jonathanyujra/revision_stick-lpc1769/README.md

# revision_stick-lpc1769
Módulo Stick LPC1769
