jonathanyujra/revision_stick-lpc1769/Gabinete/TP3-gabinete.FCStd

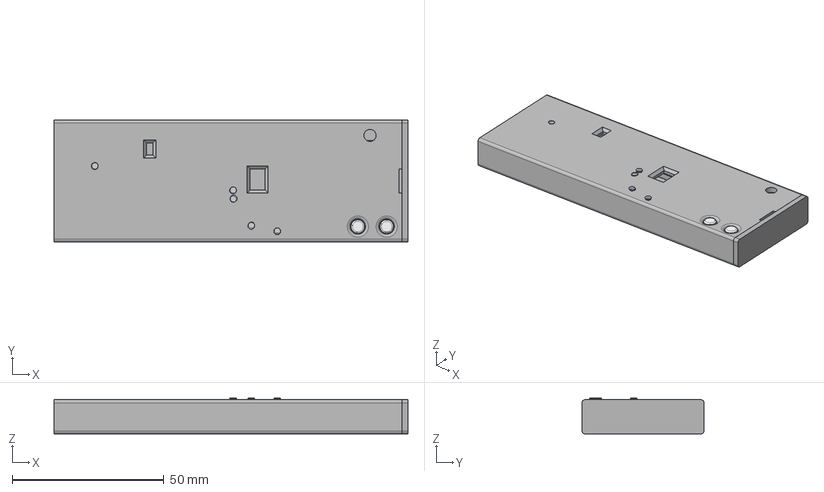
[picture p10: CAD file, 2025-09-14]
Gabinete/TP3-gabinete.FCStd
116.5 x 40.2 x 11.8 mm
Gabinete-tapa
Gabinete-sw1
Gabinete-sw2
Gabinete-cuerpo
Gabinete-TuboDeLuz
Gabinete-TuboDeLuz1
Gabinete-TuboDeLuz2
Gabinete-TuboDeLuz3
Gabinete-TuboDeLuz4
