jonathanyujra/revision_stick-lpc1769/Módulo Stick LPC 1769/modelos3d/SOIC-8-1.step

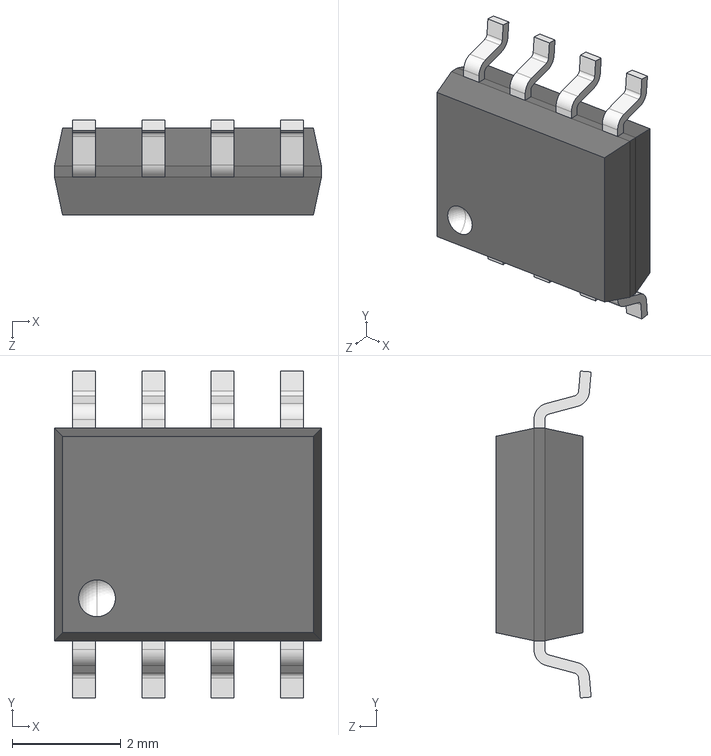
[picture p11: CAD file, 2025-09-14]
Módulo Stick LPC 1769/modelos3d/SOIC-8-1.step
4.90 x 6.00 x 1.75 mm
