jonathanyujra/revision_stick-lpc1769/Módulo Stick LPC 1769/modelos3d/VFQFN-32-5x5 - EQ.STEP

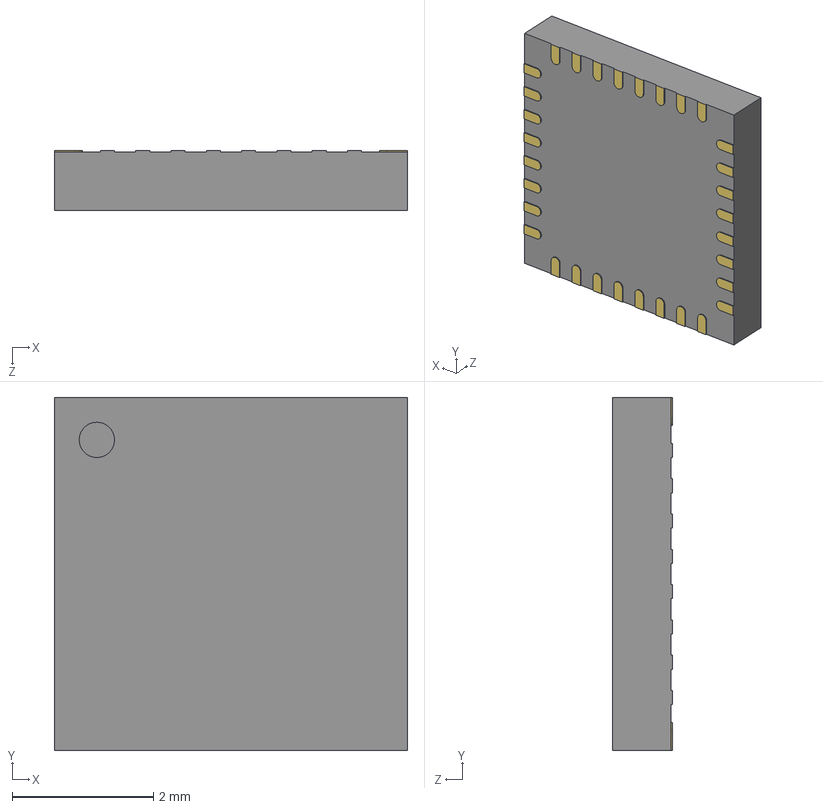
[picture p12: CAD file, 2025-09-14]
Módulo Stick LPC 1769/modelos3d/VFQFN-32-5x5 - EQ.STEP
5.00 x 5.00 x 0.85 mm
