jonathanyujra/revision_stick-lpc1769/Módulo Stick LPC 1769/modelos3d/USB2.0_MICRO_B.stp

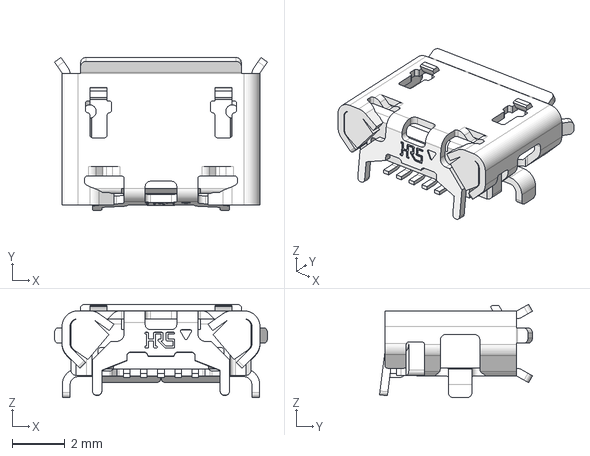
[picture p13: CAD file, 2025-09-14]
Módulo Stick LPC 1769/modelos3d/USB2.0_MICRO_B.stp
8.09 x 5.81 x 3.55 mm
