jonathanyujra/revision_stick-lpc1769/Módulo Stick LPC 1769/modelos3d/QFN65-8X8_M.STEP

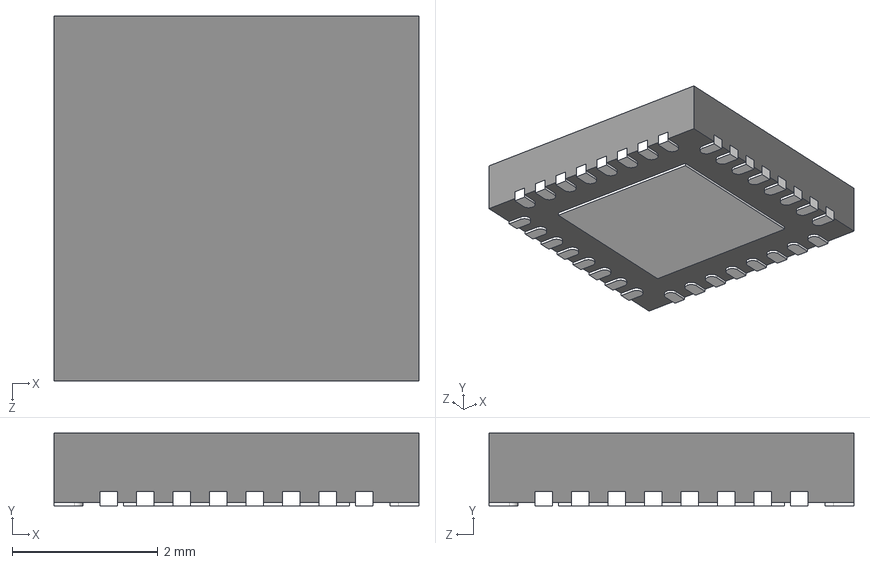
[picture p14: CAD file, 2025-09-14]
Módulo Stick LPC 1769/modelos3d/QFN65-8X8_M.STEP
5.00 x 1 x 5.00 mm
