jonathanyujra/revision_stick-lpc1769/Módulo Stick LPC 1769/modelos3d/RGB_PLCC(c).STEP

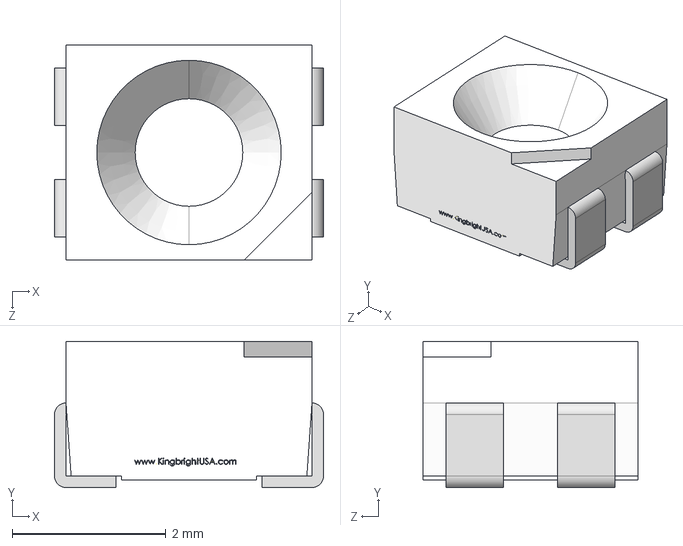
[picture p15: CAD file, 2025-09-14]
Módulo Stick LPC 1769/modelos3d/RGB_PLCC(c).STEP
3.50 x 1.90 x 2.80 mm
