jonathanyujra/revision_stick-lpc1769/Módulo Stick LPC 1769/modelos3d/M50-3600542.IGS

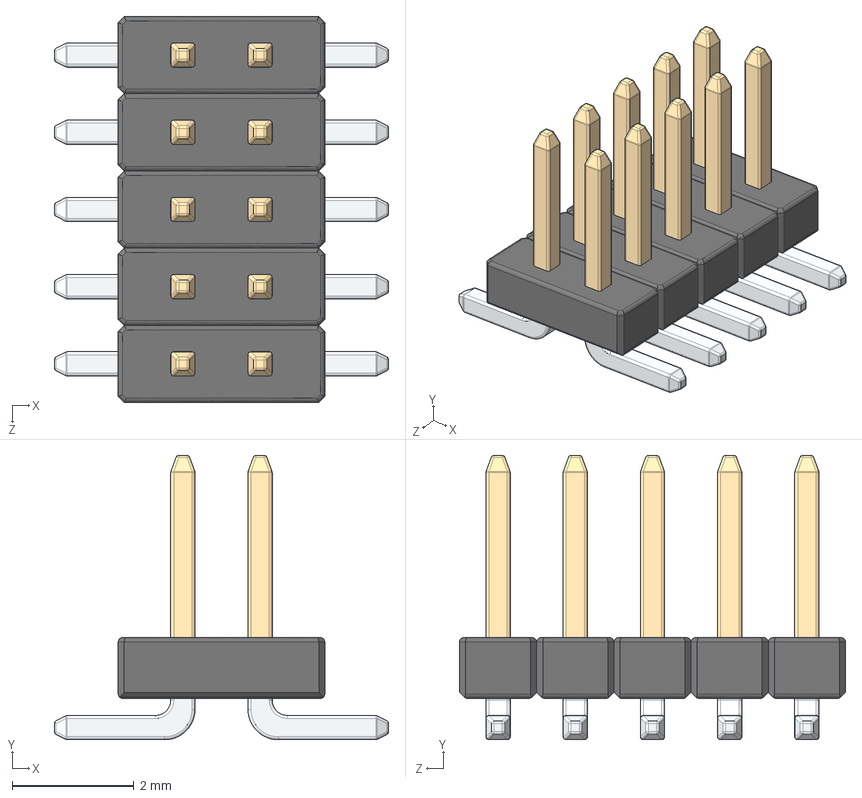
[picture p16: CAD file, 2025-09-14]
Módulo Stick LPC 1769/modelos3d/M50-3600542.IGS
5.50 x 4.68 x 6.35 mm
