jonathanyujra/revision_stick-lpc1769/Módulo Stick LPC 1769/output/Módulo Stick LPC1769-esquemático.pdf

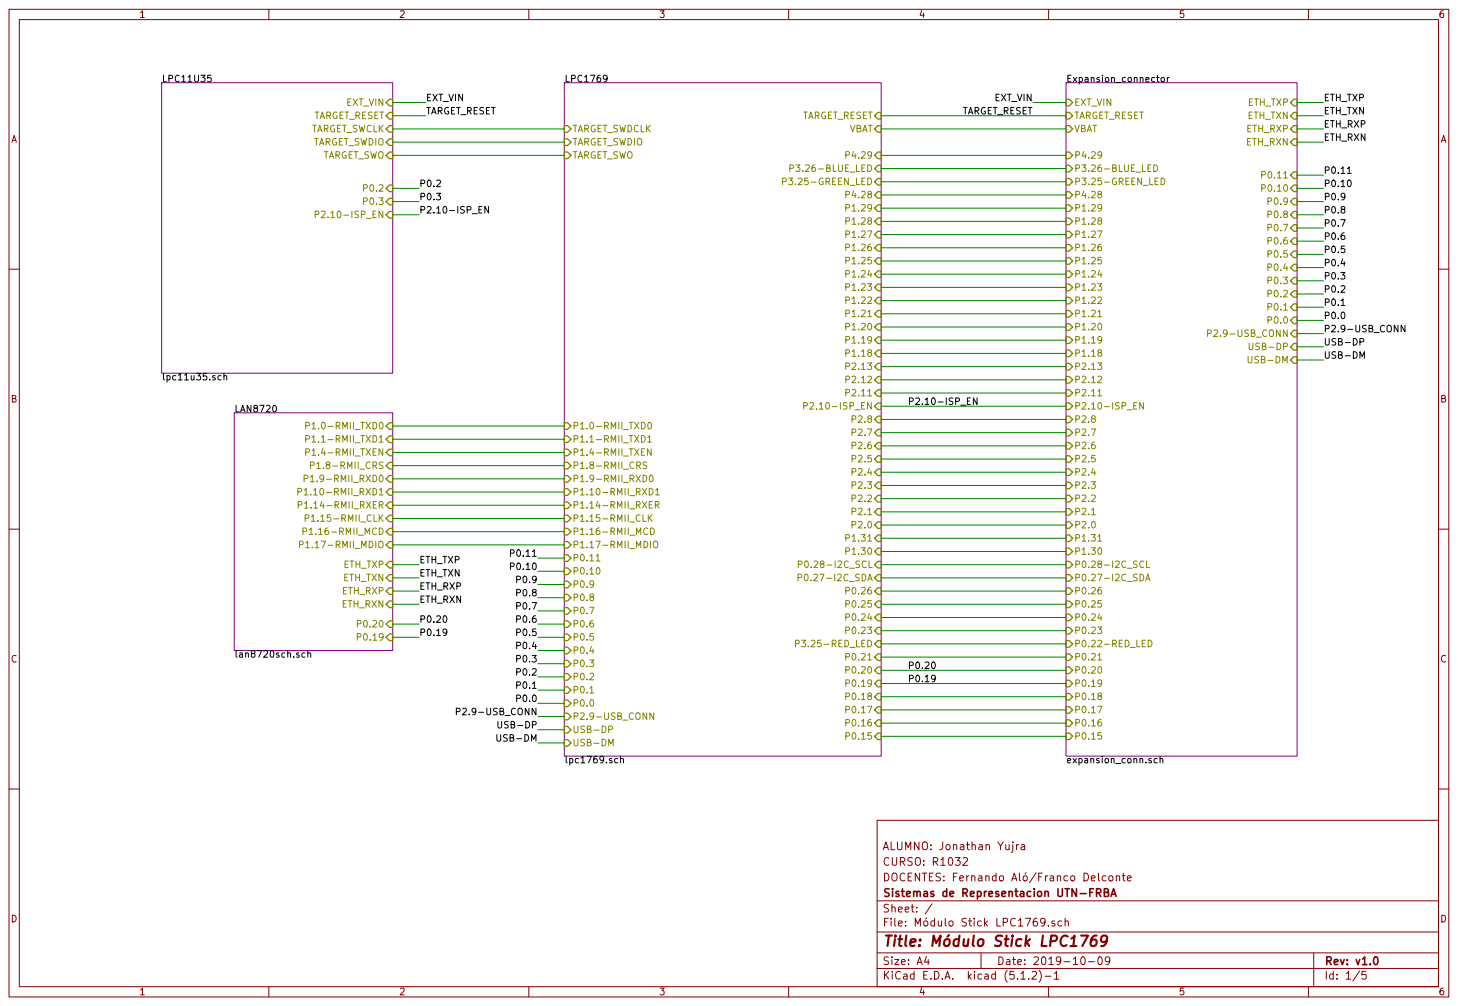
[picture p17: page 1]

USB-DP USB-DM

DOCENTES: Fernando Aló/Franco Delconte CURSO: R1032 ALUMNO: Jonathan Yujra

File: Módulo Stick LPC1769.sch Sheet: / Sistemas de Representacion UTN-FRBA

Id: 1/5 Title: Módulo Stick LPC1769

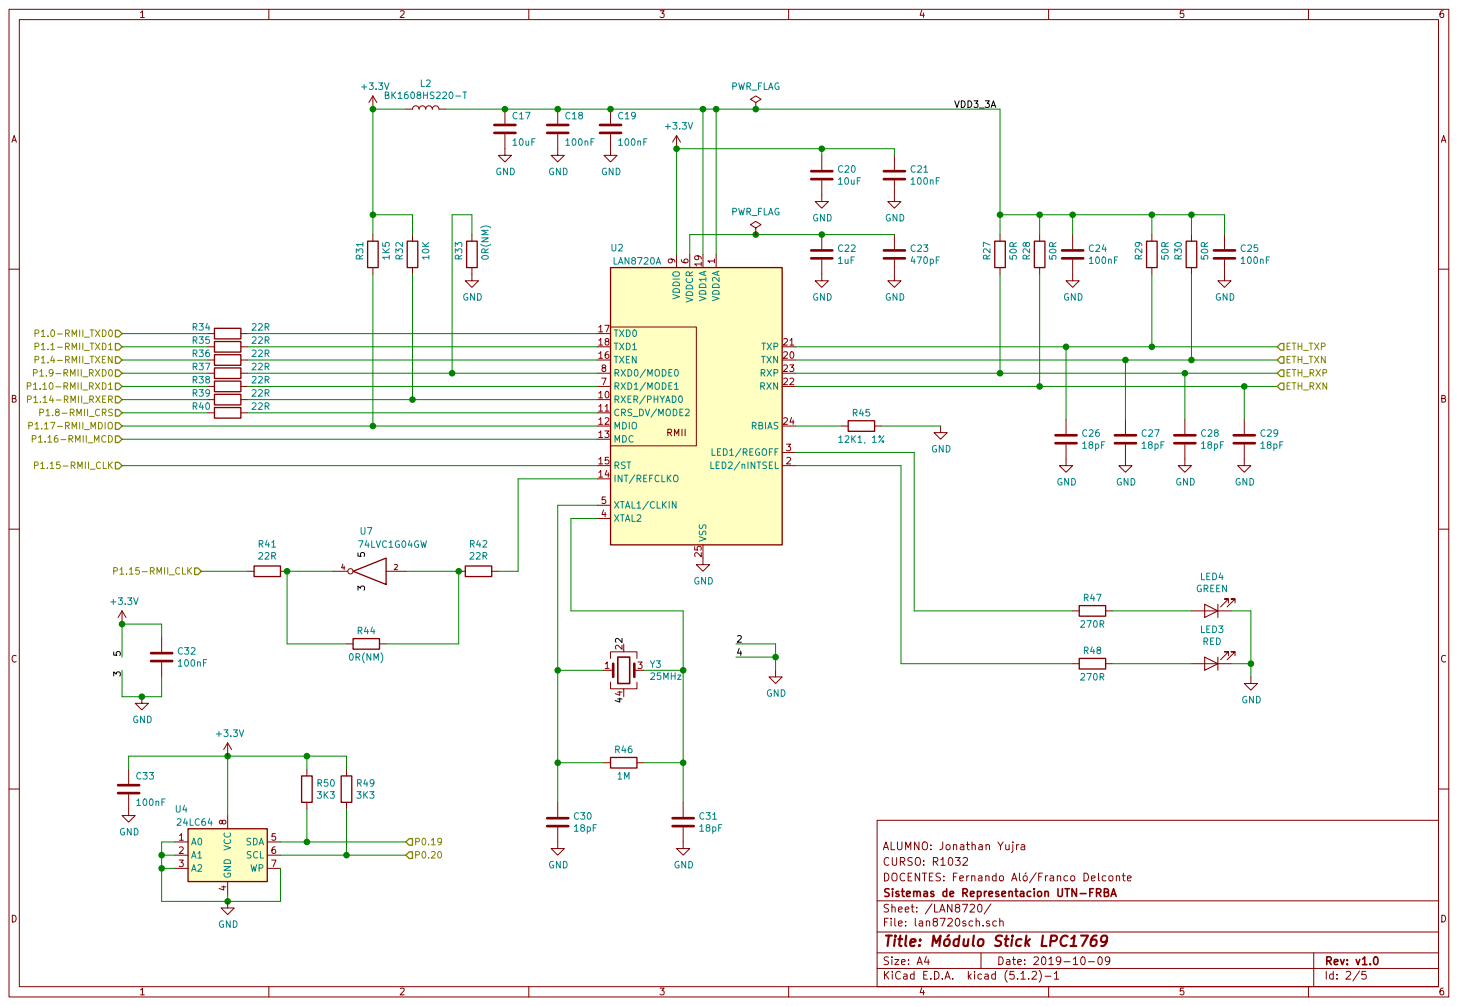
[picture p18: page 2]

4 SDA 5 SCL 6 WP 7 VCC

DOCENTES: Fernando Aló/Franco Delconte CURSO: R1032 ALUMNO: Jonathan Yujra

File: lan8720sch.sch Sheet: /LAN8720/ Sistemas de Representacion UTN-FRBA

Id: 2/5 Title: Módulo Stick LPC1769

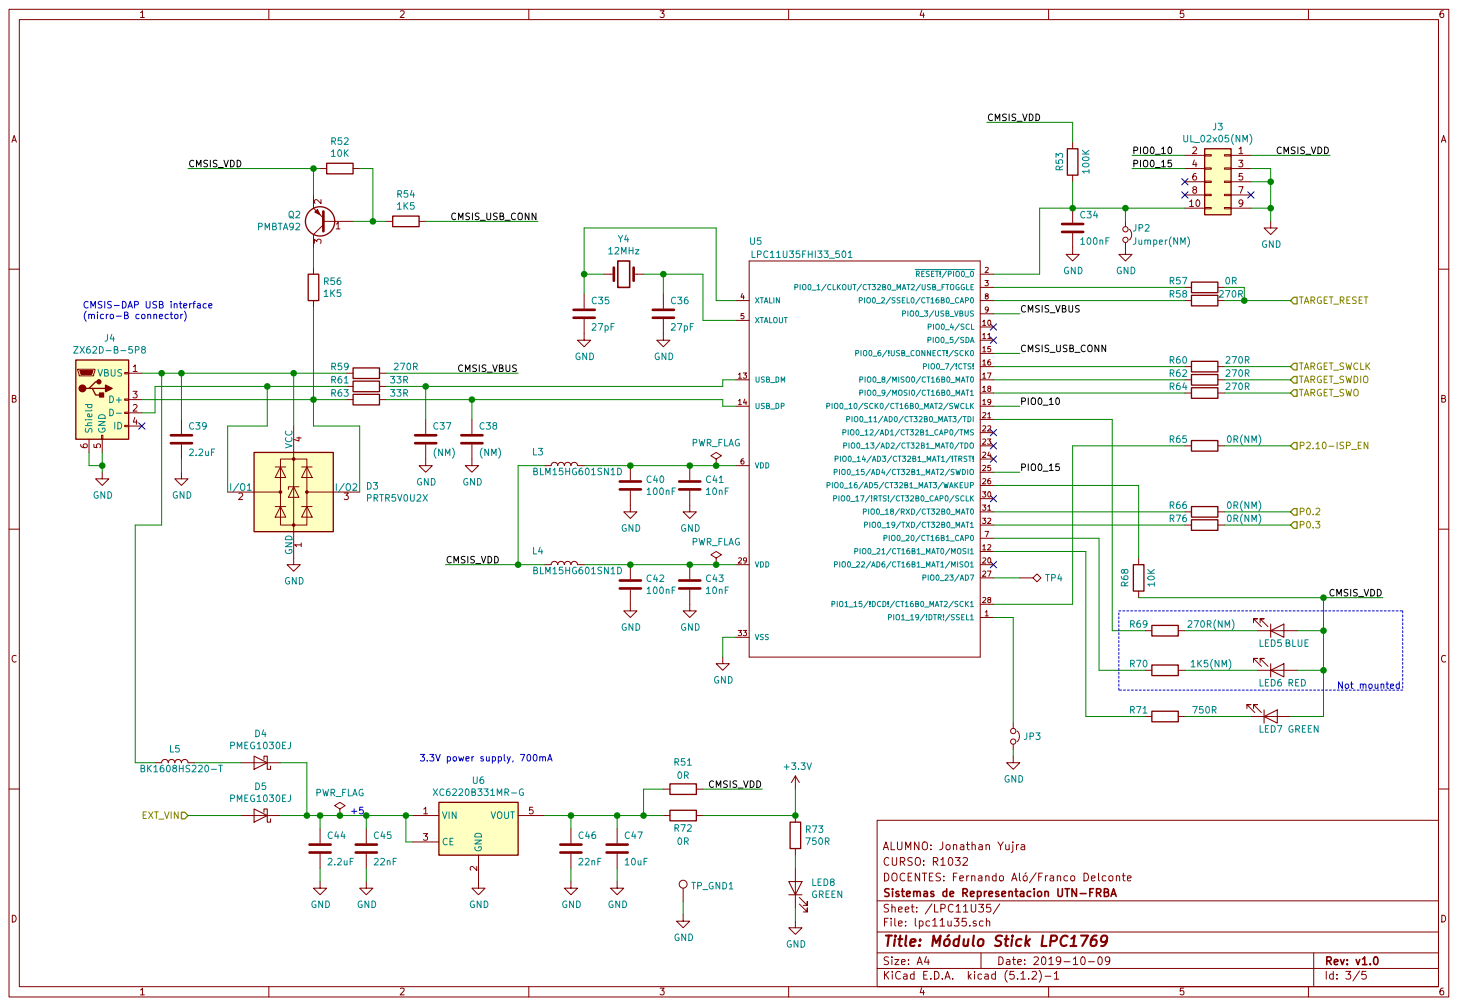
[picture p19: page 3]

3.3V power supply, 700mA CMSIS-DAP USB interface

DOCENTES: Fernando Aló/Franco Delconte CURSO: R1032 ALUMNO: Jonathan Yujra GND

File: lpc11u35.sch Sheet: /LPC11U35/ Sistemas de Representacion UTN-FRBA

Id: 3/5 Title: Módulo Stick LPC1769

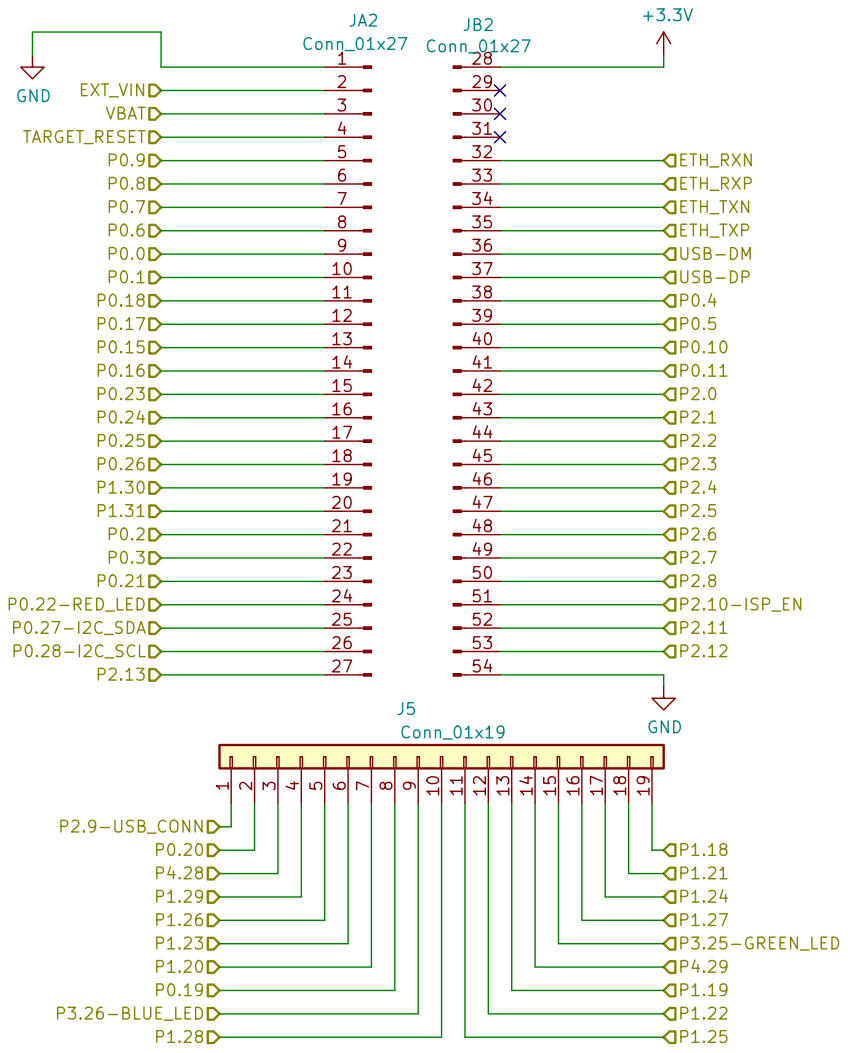
[picture p20: page 4]

Sistemas de Representacion UTN-FRBA
Sheet: /Expansion_connector/
File: expansion_conn.sch
Id: 4/5 Title: Módulo Stick LPC1769

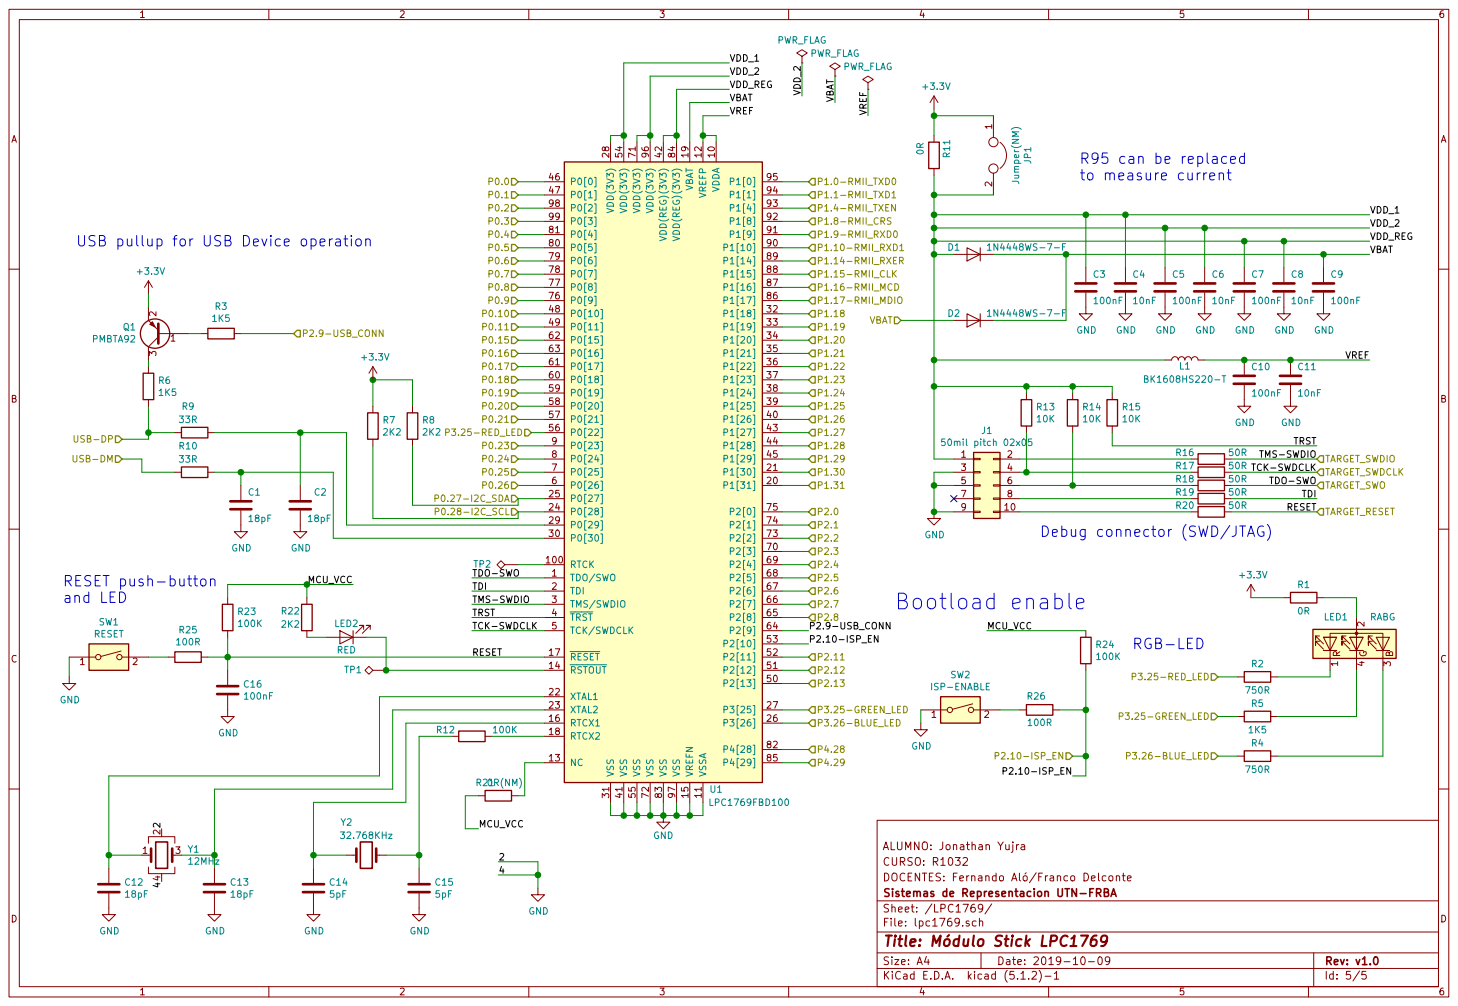
[picture p21: page 5]

USB pullup for USB Device operation

Debug connector (SWD/JTAG)

File: lpc1769.sch Sheet: /LPC1769/ Sistemas de Representacion UTN-FRBA

Id: 5/5 Title: Módulo Stick LPC1769
