jonathanyujra/revision_stick-lpc1769/Módulo Stick LPC 1769/Módulo Stick LPC 1769.kicad_pcb

## KiCad design Módulo Stick LPC 1769/Módulo Stick LPC 1769.kicad_pcb (2025-09-14)

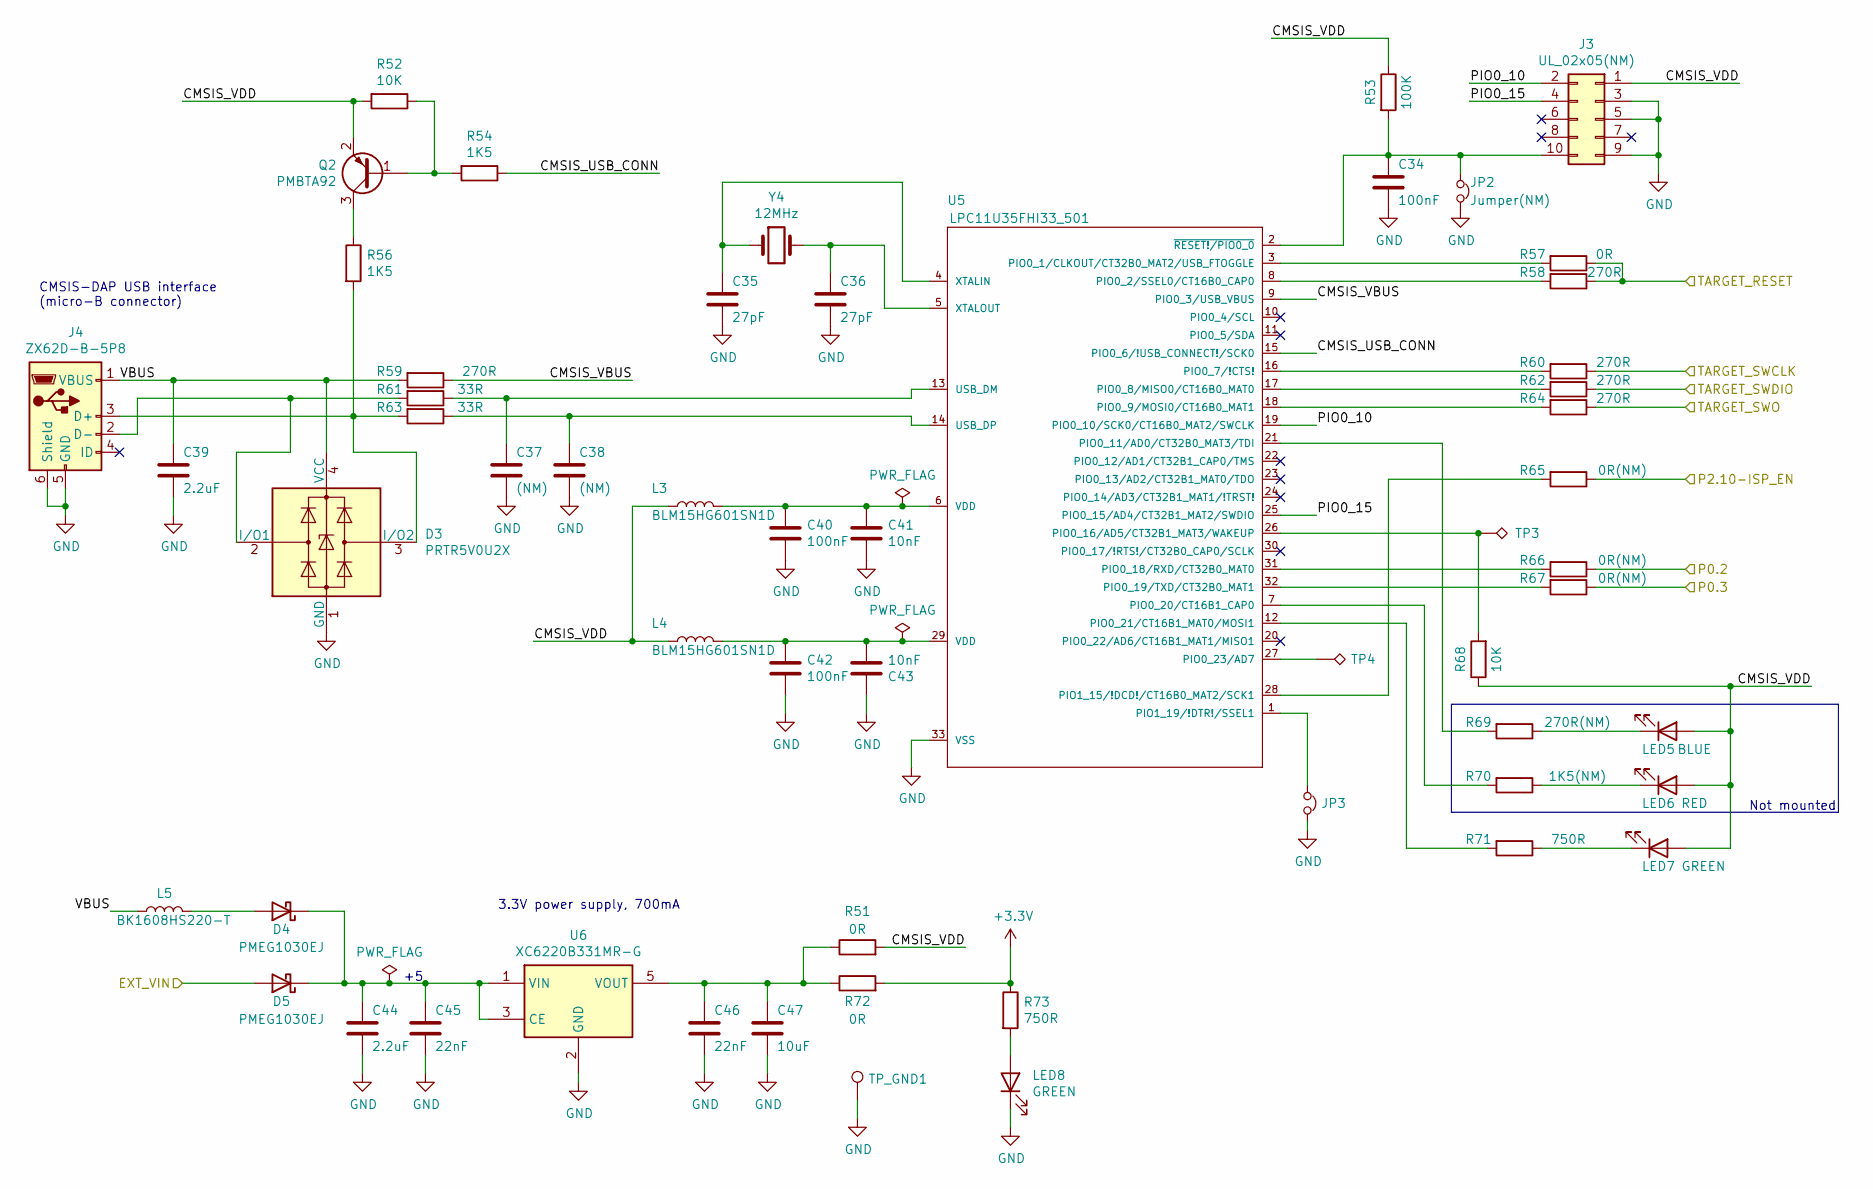
[picture p22: schematic lpc11u35.kicad_sch, Módulo Stick LPC1769]

Parts:
C34, C40, C42: 100nF; C_0603; Manufacturer P/N C0603C104Z3VACTU; Digi-Key P/N 399-1100-1-ND
C35, C36: 27pF; C_0603; Manufacturer P/N C0603C270J5GACTU; Digi-Key P/N 399-1054-1-ND
C37, C38: (NM); C_0603
C39, C44: 2.2uF; C_0805; Manufacturer P/N C0805C225K3RAC7800; Digi-Key P/N 399-11941-1-ND
C41, C43: 10nF; C_0603; Manufacturer P/N C0603C103K3RACTU; Digi-Key P/N 399-7840-1-ND
C45, C46: 22nF; C_0603; Manufacturer P/N C0603C223K3RACTU; Digi-Key P/N 399-1094-1-ND
C47: 10uF; C_0805; Manufacturer P/N C0805C106K3PAC7800; Digi-Key P/N 399-11939-1-ND
D3: PRTR5V0U2X; SOT-143; Manufacturer P/N PRTR5V0U2X,215; Digi-Key P/N 1727-3884-1-ND
D4, D5: PMEG1030EJ; D_SOD-323F; Manufacturer P/N PMEG1030EJ,115; Digi-Key P/N 1727-3852-1-ND
J3: UL_02x05(NM); M50-3600542
J4: ZX62D-B-5P8; USB_Micro-B; Manufacturer P/N 10118193-0001LF; Digi-Key P/N 609-4616-2-ND
JP2: Jumper(NM); Pin_Header_Straight_1x02_Pitch2.54mm
JP3: Jumper; Pin_Header_Straight_1x02_Pitch2.54mm_SMD_Pin1Right; Manufacturer P/N M50-3630242; Digi-Key P/N 952-3606-ND
L3, L4: BLM15HG601SN1D; L_0402; Manufacturer P/N BLM15HG601SN1D; Digi-Key P/N 490-3998-1-ND
L5: BK1608HS220-T; L_0603; Manufacturer P/N BK1608HS220-T; Digi-Key P/N 587-1869-1-ND
LED5: BLUE; LED_0603; Manufacturer P/N 150060BS55040; Digi-Key P/N 732-12013-1-ND
LED6: RED; LED_0603; Manufacturer P/N 150060RS55040; Digi-Key P/N 732-12015-1-ND
LED7, LED8: GREEN; LED_0603; Manufacturer P/N 150060VS55040; Digi-Key P/N 732-12017-1-ND
Q2: PMBTA92; SOT-23; Manufacturer P/N PMBTA92,215; Digi-Key P/N 1727-2966-1-ND
R51, R57, R72: 0R; R_0603; Manufacturer P/N RC0603JR-070RL; Digi-Key P/N 311-0.0GRCT-ND
R52, R68: 10K; R_0603; Manufacturer P/N RC0603JR-0710KL; Digi-Key P/N 311-10KGRCT-ND
R53: 100K; R_0603; Manufacturer P/N RC0603JR-07100KL; Digi-Key P/N 311-100KGRCT-ND
R54, R56: 1K5; R_0603; Manufacturer P/N RC0603JR-071K5L; Digi-Key P/N 311-1.5KGRCT-ND
R58, R59, R60, R62, R64: 270R; R_0603; Manufacturer P/N RC0603JR-07270RL; Digi-Key P/N 311-270GRCT-ND
R61, R63: 33R; R_0603; Manufacturer P/N RC0603JR-0733RL; Digi-Key P/N 311-33GRCT-ND
R65, R66, R67: 0R(NM); R_0603
R69: 270R(NM); R_0603
R70: 1K5(NM); R_0603
R71, R73: 750R; R_0603; Manufacturer P/N RC0603JR-07750RL; Digi-Key P/N 311-750GRCT-ND
TP3, TP4: TestPoint; TestPoint-SMD-S
TP_GND1: TestPoint; TestPoint-SMD-S
U5: LPC11U35FHI33_501; QFN65-8X8_M-33N; Manufacturer P/N LPC11U35FHI33/501; Digi-Key P/N 568-9586-ND
U6: XC6220B331MR-G; SOT-25; Manufacturer P/N XC6220B331MR-G; Digi-Key P/N 893-1133-1-ND
Y4: 12MHz; Crystal_SMD_HC49-SD; Manufacturer P/N ECS-120-20-5PX-TR; Digi-Key P/N XC2080CT-ND

Connections:
+3V3: R72.2, R73.1; also elsewhere on the board
/EXT_VIN: D5.2 (A); also elsewhere on the board
/LPC11U35/CMSIS_USB_CONN: R54.1, U5.15 (PIO0_6/!USB_CONNECT!/SCK0)
/LPC11U35/CMSIS_VBUS: R59.1, U5.9 (PIO0_3/USB_VBUS)
/LPC11U35/CMSIS_VDD: J3.1, L3.1, L4.1, LED5.2 (A), LED6.2 (A), LED7.2 (A), Q2.2 (E), R51.2, R52.2, R53.1, R68.1
/LPC11U35/PIO0_10: J3.2, U5.19 (PIO0_10/SCK0/CT16B0_MAT2/SWCLK)
/LPC11U35/PIO0_15: J3.4, U5.25 (PIO0_15/AD4/CT32B1_MAT2/SWDIO)
/LPC11U35/TARGET_SWCLK: R60.1; also elsewhere on the board
/LPC11U35/TARGET_SWDIO: R62.1; also elsewhere on the board
/LPC11U35/TARGET_SWO: R64.1; also elsewhere on the board
/P0.2: R66.1; also elsewhere on the board
/P0.3: R67.1; also elsewhere on the board
/P2.10-ISP_EN: R65.1; also elsewhere on the board
/TARGET_RESET: R57.1, R58.1; also elsewhere on the board
GND: C34.2, C35.2, C36.2, C37.2, C38.2, C39.2, C40.2, C41.2, C42.2, C43.1, C44.2, C45.2, C46.2, C47.2, D3.1 (GND), J3.3, J3.5, J3.9, J4.5 (GND), J4.6 (Shield), JP2.2, JP3.2, LED8.1 (K), TP_GND1.1, U5.33 (VSS), U6.2 (GND); also elsewhere on the board
unnamed: C34.1, J3.10, JP2.1, R53.2, U5.2 (~RESET!/PIO0_0)
unnamed: C35.1, U5.4 (XTALIN), Y4.1
unnamed: C36.1, U5.5 (XTALOUT), Y4.2
unnamed: C37.1, R61.1, U5.13 (USB_DM)
unnamed: C38.1, R63.1, U5.14 (USB_DP)
unnamed: C39.1, D3.4 (VCC), J4.1 (VBUS), L5.1, R59.2
unnamed: C40.1, C41.1, L3.2, U5.6 (VDD)
unnamed: C42.1, C43.2, L4.2, U5.29 (VDD)
unnamed: C44.1, C45.1, D4.1 (K), D5.1 (K), U6.1 (VIN), U6.3 (CE)
unnamed: C46.1, C47.1, R51.1, R72.1, U6.5 (VOUT)
unnamed: D3.2 (I/O1), J4.2 (D-), R61.2
unnamed: D3.3 (I/O2), J4.3 (D+), R56.2, R63.2
unnamed: D4.2 (A), L5.2
unnamed: JP3.1, U5.1 (PIO1_19/!DTR!/SSEL1)
unnamed: LED5.1 (K), R69.1
unnamed: LED6.1 (K), R70.1
unnamed: LED7.1 (K), R71.1
unnamed: LED8.2 (A), R73.2
unnamed: Q2.1 (B), R52.1, R54.2
unnamed: Q2.3 (C), R56.1
unnamed: R57.2, U5.3 (PIO0_1/CLKOUT/CT32B0_MAT2/USB_FTOGGLE)
unnamed: R58.2, U5.8 (PIO0_2/SSEL0/CT16B0_CAP0)
unnamed: R60.2, U5.16 (PIO0_7/!CTS!)
unnamed: R62.2, U5.17 (PIO0_8/MISO0/CT16B0_MAT0)
unnamed: R64.2, U5.18 (PIO0_9/MOSI0/CT16B0_MAT1)
unnamed: R65.2, U5.28 (PIO1_15/!DCD!/CT16B0_MAT2/SCK1)
unnamed: R66.2, U5.31 (PIO0_18/RXD/CT32B0_MAT0)
unnamed: R67.2, U5.32 (PIO0_19/TXD/CT32B0_MAT1)
unnamed: R68.2, TP3.1, U5.26 (PIO0_16/AD5/CT32B1_MAT3/WAKEUP)
unnamed: R69.2, U5.21 (PIO0_11/AD0/CT32B0_MAT3/TDI)
unnamed: R70.2, U5.7 (PIO0_20/CT16B1_CAP0)
unnamed: R71.2, U5.12 (PIO0_21/CT16B1_MAT0/MOSI1)
unnamed: TP4.1, U5.27 (PIO0_23/AD7)

Notes on the sheet:
CMSIS-DAP USB interface (micro-B connector)
3.3V power supply, 700mA
Not mounted

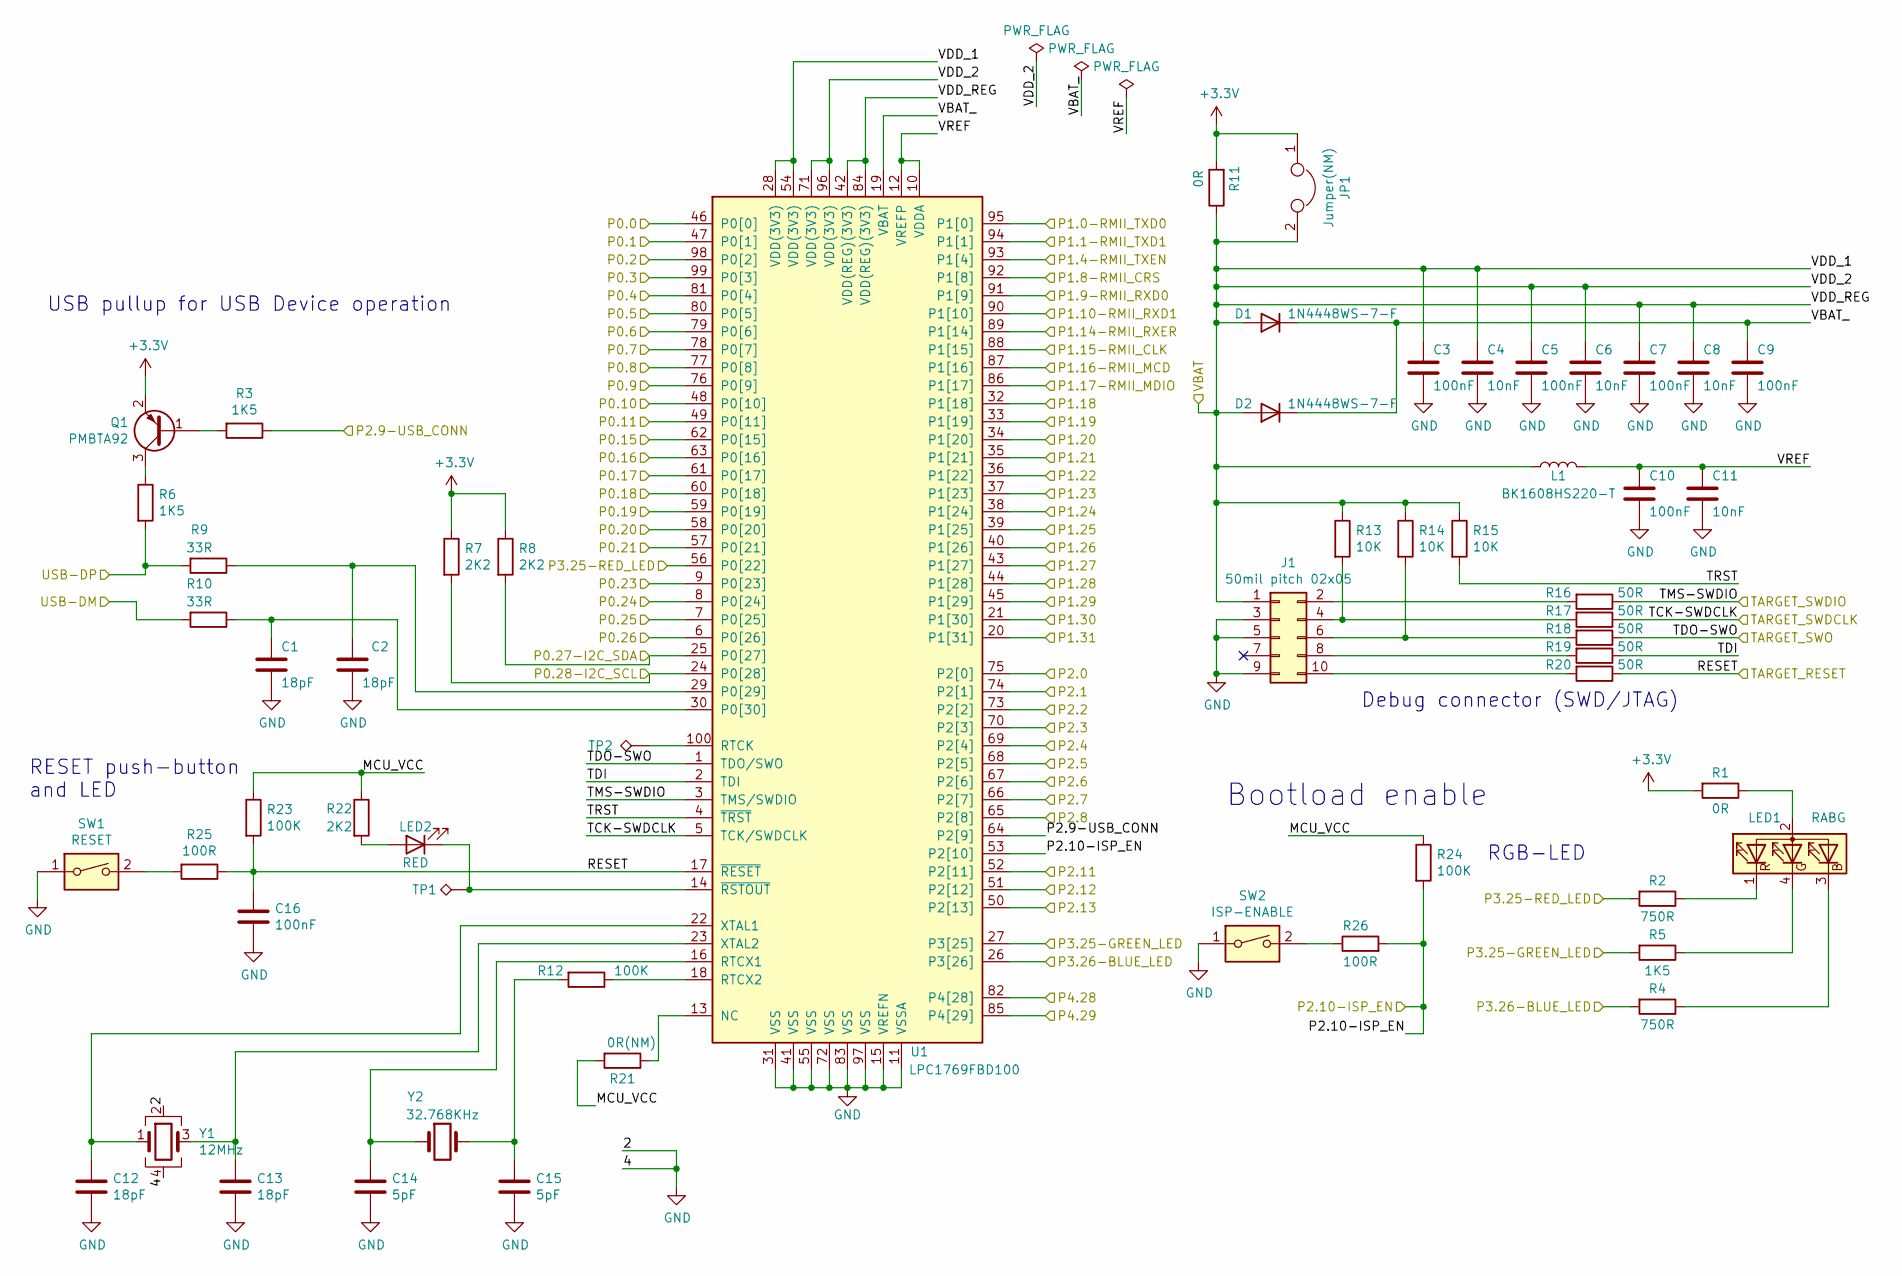
[picture p23: schematic lpc1769.kicad_sch, Módulo Stick LPC1769]

Parts:
C1, C2, C12, C13: 18pF; C_0603; Manufacturer P/N C0603C180J5GACTU; Digi-Key P/N 399-1052-1-ND
C3, C5, C7, C9, C10, C16: 100nF; C_0603; Manufacturer P/N C0603C104Z3VACTU; Digi-Key P/N 399-1100-1-ND
C4, C6, C8, C11: 10nF; C_0603; Manufacturer P/N C0603C103K3RACTU; Digi-Key P/N 399-7840-1-ND
C14, C15: 5pF; C_0603; Manufacturer P/N CBR06C509C5GAC; Digi-Key P/N 399-17324-1-ND
D1, D2: 1N4448WS-7-F; D_SOD-323; Manufacturer P/N 1N4448WS-7-F; Digi-Key P/N 1N4448WS-FDICT-ND
J1: 50mil pitch 02x05; M50-3600542; Manufacturer P/N M50-3600542; Digi-Key P/N 952-1389-ND
JP1: Jumper(NM); Pin_Header_Straight_1x02_Pitch2.54mm
L1: BK1608HS220-T; L_0603; Manufacturer P/N BK1608HS220-T; Digi-Key P/N 587-1869-1-ND
LED1: RABG; LED_RGB_1210; Manufacturer P/N AAA3528SEEZGKQBKS; Digi-Key P/N 754-1973-1-ND
LED2: RED; LED_0603; Manufacturer P/N 150060RS55040; Digi-Key P/N 732-12015-1-ND
Q1: PMBTA92; SOT-23; Manufacturer P/N PMBTA92,215; Digi-Key P/N 1727-2966-1-ND
R1, R11: 0R; R_0603; Manufacturer P/N RC0603JR-070RL; Digi-Key P/N 311-0.0GRCT-ND
R2, R4: 750R; R_0603; Manufacturer P/N RC0603JR-07750RL; Digi-Key P/N 311-750GRCT-ND
R3, R5, R6: 1K5; R_0603; Manufacturer P/N RC0603JR-071K5L; Digi-Key P/N 311-1.5KGRCT-ND
R7, R8, R22: 2K2; R_0603; Manufacturer P/N RC0603JR-072K2L; Digi-Key P/N 311-2.2KGRCT-ND
R9, R10: 33R; R_0603; Manufacturer P/N RC0603JR-0733RL; Digi-Key P/N 311-33GRCT-ND
R12, R23, R24: 100K; R_0603; Manufacturer P/N RC0603JR-07100KL; Digi-Key P/N 311-100KGRCT-ND
R13, R14, R15: 10K; R_0603; Manufacturer P/N RC0603JR-0710KL; Digi-Key P/N 311-10KGRCT-ND
R16, R17, R18, R19, R20: 50R; R_0603; Manufacturer P/N CRCW060350R0FKEA; Digi-Key P/N 541-3318-1-ND
R21: 0R(NM); R_0603
R25, R26: 100R; R_0603; Manufacturer P/N RC0603JR-07100RL; Digi-Key P/N 311-100GRCT-ND
SW1: RESET; SW_2.80x4.60mm; Manufacturer P/N TL6330AF200Q; Digi-Key P/N EG5546CT-ND
SW2: ISP-ENABLE; SW_2.80x4.60mm; Manufacturer P/N TL6330AF200Q; Digi-Key P/N EG5546CT-ND
TP1, TP2: TestPoint; TestPoint-SMD-S
U1: LPC1769FBD100; Manufacturer P/N LPC1769FBD100,551; Digi-Key P/N 568-4966-ND
Y1: 12MHz; Crystal_SMD_3225-4pin_3.2x2.5mm; Manufacturer P/N ECS-120-18-33-AGN-TR; Digi-Key P/N XC2910CT-ND
Y2: 32.768KHz; Crystal_SMD_SeikoEpson_MC146-4pin_6.7x1.5mm; Manufacturer P/N MC-146 32.7680KA-A5: PURE SN; Digi-Key P/N SER4301CT-ND

Connections:
+3V3: JP1.1, Q1.2 (E), R1.2, R7.1, R8.1, R11.2; also elsewhere on the board
/Expansion_connector/P0.15: U1.62 (P0[15]); also elsewhere on the board
/Expansion_connector/P0.16: U1.63 (P0[16]); also elsewhere on the board
/Expansion_connector/P0.17: U1.61 (P0[17]); also elsewhere on the board
/Expansion_connector/P0.18: U1.60 (P0[18]); also elsewhere on the board
/Expansion_connector/P0.21: U1.57 (P0[21]); also elsewhere on the board
/Expansion_connector/P0.22-RED_LED: R2.2, U1.56 (P0[22]); also elsewhere on the board
/Expansion_connector/P0.23: U1.9 (P0[23]); also elsewhere on the board
/Expansion_connector/P0.24: U1.8 (P0[24]); also elsewhere on the board
/Expansion_connector/P0.25: U1.7 (P0[25]); also elsewhere on the board
/Expansion_connector/P0.26: U1.6 (P0[26]); also elsewhere on the board
/Expansion_connector/P0.27-I2C_SDA: R8.2, U1.25 (P0[27]); also elsewhere on the board
/Expansion_connector/P0.28-I2C_SCL: R7.2, U1.24 (P0[28]); also elsewhere on the board
/Expansion_connector/P1.18: U1.32 (P1[18]); also elsewhere on the board
/Expansion_connector/P1.19: U1.33 (P1[19]); also elsewhere on the board
/Expansion_connector/P1.20: U1.34 (P1[20]); also elsewhere on the board
/Expansion_connector/P1.21: U1.35 (P1[21]); also elsewhere on the board
/Expansion_connector/P1.22: U1.36 (P1[22]); also elsewhere on the board
/Expansion_connector/P1.23: U1.37 (P1[23]); also elsewhere on the board
/Expansion_connector/P1.24: U1.38 (P1[24]); also elsewhere on the board
/Expansion_connector/P1.25: U1.39 (P1[25]); also elsewhere on the board
/Expansion_connector/P1.26: U1.40 (P1[26]); also elsewhere on the board
/Expansion_connector/P1.27: U1.43 (P1[27]); also elsewhere on the board
/Expansion_connector/P1.28: U1.44 (P1[28]); also elsewhere on the board
/Expansion_connector/P1.29: U1.45 (P1[29]); also elsewhere on the board
/Expansion_connector/P1.30: U1.21 (P1[30]); also elsewhere on the board
/Expansion_connector/P1.31: U1.20 (P1[31]); also elsewhere on the board
/Expansion_connector/P2.0: U1.75 (P2[0]); also elsewhere on the board
/Expansion_connector/P2.1: U1.74 (P2[1]); also elsewhere on the board
/Expansion_connector/P2.2: U1.73 (P2[2]); also elsewhere on the board
/Expansion_connector/P2.3: U1.70 (P2[3]); also elsewhere on the board
/Expansion_connector/P2.4: U1.69 (P2[4]); also elsewhere on the board
/Expansion_connector/P2.5: U1.68 (P2[5]); also elsewhere on the board
/Expansion_connector/P2.6: U1.67 (P2[6]); also elsewhere on the board
/Expansion_connector/P2.7: U1.66 (P2[7]); also elsewhere on the board
/Expansion_connector/P2.8: U1.65 (P2[8]); also elsewhere on the board
/Expansion_connector/P2.11: U1.52 (P2[11]); also elsewhere on the board
/Expansion_connector/P2.12: U1.51 (P2[12]); also elsewhere on the board
/Expansion_connector/P2.13: U1.50 (P2[13]); also elsewhere on the board
/Expansion_connector/P3.25-GREEN_LED: R5.2, U1.27 (P3[25]); also elsewhere on the board
/Expansion_connector/P3.26-BLUE_LED: R4.2, U1.26 (P3[26]); also elsewhere on the board
/Expansion_connector/P4.28: U1.82 (P4[28]); also elsewhere on the board
/Expansion_connector/P4.29: U1.85 (P4[29]); also elsewhere on the board
/LAN8720/P1.0-RMII_TXD0: U1.95 (P1[0]); also elsewhere on the board
/LAN8720/P1.1-RMII_TXD1: U1.94 (P1[1]); also elsewhere on the board
/LAN8720/P1.4-RMII_TXEN: U1.93 (P1[4]); also elsewhere on the board
/LAN8720/P1.8-RMII_CRS: U1.92 (P1[8]); also elsewhere on the board
/LAN8720/P1.9-RMII_RXD0: U1.91 (P1[9]); also elsewhere on the board
/LAN8720/P1.10-RMII_RXD1: U1.90 (P1[10]); also elsewhere on the board
/LAN8720/P1.14-RMII_RXER: U1.89 (P1[14]); also elsewhere on the board
/LAN8720/P1.15-RMII_CLK: U1.88 (P1[15]); also elsewhere on the board
/LAN8720/P1.16-RMII_MCD: U1.87 (P1[16]); also elsewhere on the board
/LAN8720/P1.17-RMII_MDIO: U1.86 (P1[17]); also elsewhere on the board
/LPC11U35/TARGET_SWCLK: R17.1, U1.5 (TCK/SWDCLK); also elsewhere on the board
/LPC11U35/TARGET_SWDIO: R16.1, U1.3 (TMS/SWDIO); also elsewhere on the board
/LPC11U35/TARGET_SWO: R18.1, U1.1 (TDO/SWO); also elsewhere on the board
/LPC1769/MCU_VCC: R21.2, R22.1, R23.1, R24.1
/LPC1769/TDI: R19.1, U1.2 (TDI)
/LPC1769/TRST: R15.2, U1.4 (~TRST)
/LPC1769/VBAT_: C9.1, D1.1 (K), D2.1 (K), U1.19 (VBAT)
/LPC1769/VREF: C10.1, C11.1, L1.2, U1.10 (VDDA), U1.12 (VREFP)
/P0.0: U1.46 (P0[0]); also elsewhere on the board
/P0.1: U1.47 (P0[1]); also elsewhere on the board
/P0.2: U1.98 (P0[2]); also elsewhere on the board
/P0.3: U1.99 (P0[3]); also elsewhere on the board
/P0.4: U1.81 (P0[4]); also elsewhere on the board
/P0.5: U1.80 (P0[5]); also elsewhere on the board
/P0.6: U1.79 (P0[6]); also elsewhere on the board
/P0.7: U1.78 (P0[7]); also elsewhere on the board
/P0.8: U1.77 (P0[8]); also elsewhere on the board
/P0.9: U1.76 (P0[9]); also elsewhere on the board
/P0.10: U1.48 (P0[10]); also elsewhere on the board
/P0.11: U1.49 (P0[11]); also elsewhere on the board
/P0.19: U1.59 (P0[19]); also elsewhere on the board
/P0.20: U1.58 (P0[20]); also elsewhere on the board
/P2.9-USB_CONN: R3.1, U1.64 (P2[9]); also elsewhere on the board
/P2.10-ISP_EN: R24.2, R26.2, U1.53 (P2[10]); also elsewhere on the board
/TARGET_RESET: C16.1, R20.1, R23.2, R25.1, U1.17 (~RESET); also elsewhere on the board
/USB-DM: R10.2; also elsewhere on the board
/USB-DP: R6.2, R9.2; also elsewhere on the board
GND: C1.2, C2.2, C3.2, C4.2, C5.2, C6.2, C7.2, C8.2, C9.2, C10.2, C11.2, C12.2, C13.2, C14.2, C15.2, C16.2, J1.3, J1.5, J1.9, SW1.1, SW2.1, U1.11 (VSSA), U1.15 (VREFN), U1.31 (VSS), U1.41 (VSS), U1.55 (VSS), U1.72 (VSS), U1.83 (VSS), U1.97 (VSS), Y1.2, Y1.4; also elsewhere on the board
unnamed: C1.1, R10.1, U1.30 (P0[30])
unnamed: C2.1, R9.1, U1.29 (P0[29])
unnamed: C12.1, U1.22 (XTAL1), Y1.1
unnamed: C13.1, U1.23 (XTAL2), Y1.3
unnamed: C14.1, U1.16 (RTCX1), Y2.1
unnamed: C15.1, R12.2, Y2.2
unnamed: J1.2, R16.2
unnamed: J1.4, R13.2, R17.2
unnamed: J1.6, R14.2, R18.2
unnamed: J1.8, R19.2
unnamed: J1.10, R20.2
unnamed: LED1.1 (RK), R2.1
unnamed: LED1.2 (A), R1.1
unnamed: LED1.3 (BK), R4.1
unnamed: LED1.4 (GK), R5.1
unnamed: LED2.1 (K), TP1.1, U1.14 (~RSTOUT)
unnamed: LED2.2 (A), R22.2
unnamed: Q1.1 (B), R3.2
unnamed: Q1.3 (C), R6.1
unnamed: R12.1, U1.18 (RTCX2)
unnamed: R21.1, U1.13 (NC)
unnamed: R25.2, SW1.2
unnamed: R26.1, SW2.2
unnamed: TP2.1, U1.100 (RTCK)

Notes on the sheet:
Debug connector (SWD/JTAG)
RGB-LED
USB pullup for USB Device operation
RESET push-button and LED
Bootload enable

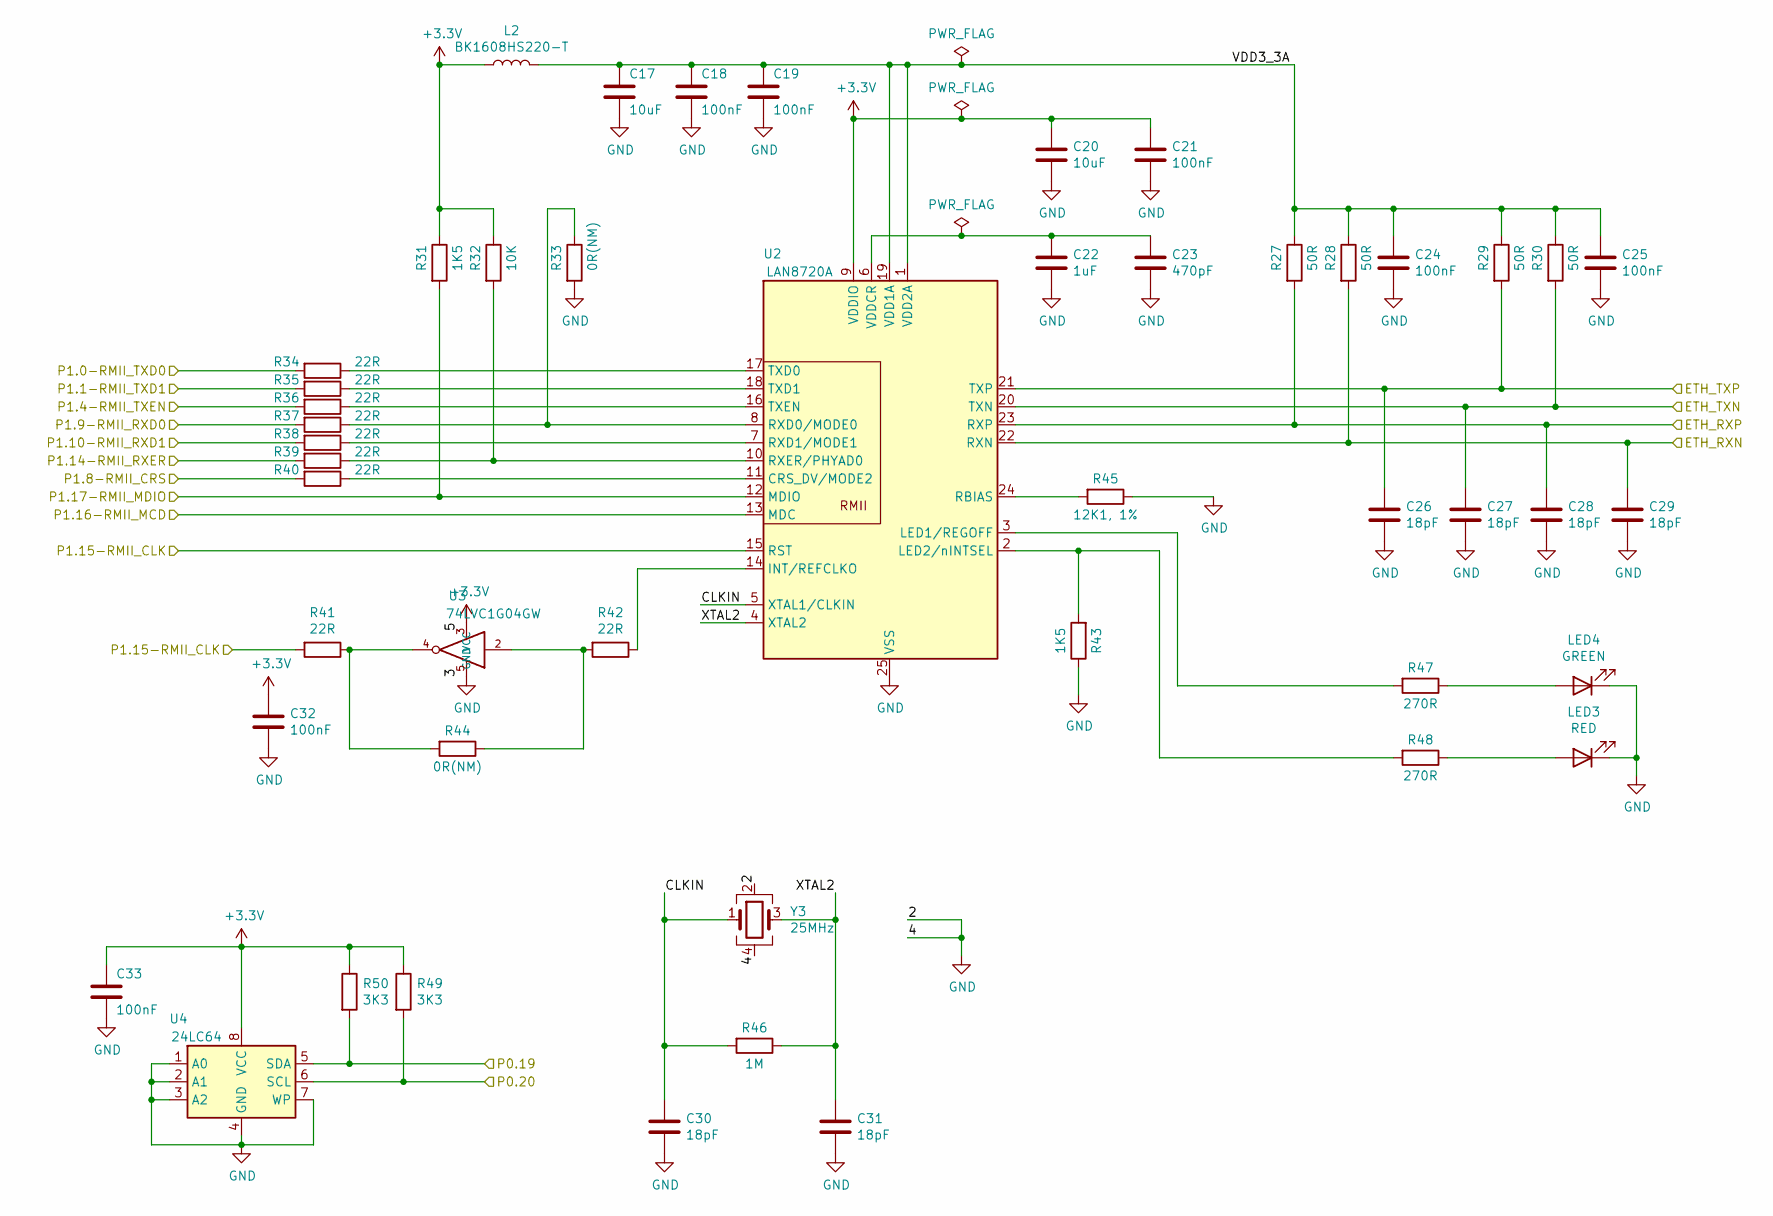
[picture p24: schematic lan8720sch.kicad_sch, Módulo Stick LPC1769]

Parts:
C17, C20: 10uF; C_0805; Manufacturer P/N C0805C106K3PAC7800; Digi-Key P/N 399-11939-1-ND
C18, C19, C21, C24, C25, C32, C33: 100nF; C_0603; Manufacturer P/N C0603C104Z3VACTU; Digi-Key P/N 399-1100-1-ND
C22: 1uF; C_0805; Manufacturer P/N C0805C105K3RACTU; Digi-Key P/N 399-8004-1-ND
C23: 470pF; C_0603; Manufacturer P/N C0603C471K5RACTU; Digi-Key P/N 399-1075-1-ND
C26, C27, C28, C29, C30, C31: 18pF; C_0603; Manufacturer P/N C0603C180J5GACTU; Digi-Key P/N 399-1052-1-ND
L2: BK1608HS220-T; L_0603; Manufacturer P/N BK1608HS220-T; Digi-Key P/N 587-1869-1-ND
LED3: RED; LED_0603; Manufacturer P/N 150060RS55040; Digi-Key P/N 732-12015-1-ND
LED4: GREEN; LED_0603; Manufacturer P/N 150060VS55040; Digi-Key P/N 732-12017-1-ND
R27, R28, R29, R30: 50R; R_0603; Manufacturer P/N CRCW060350R0FKEA; Digi-Key P/N 541-3318-1-ND
R31, R43: 1K5; R_0603; Manufacturer P/N RC0603JR-071K5L; Digi-Key P/N 311-1.5KGRCT-ND
R32: 10K; R_0603; Manufacturer P/N RC0603JR-0710KL; Digi-Key P/N 311-10KGRCT-ND
R33, R44: 0R(NM); R_0603
R34, R35, R36, R37, R38, R39, R40, R41, R42: 22R; R_0603; Manufacturer P/N RC0603JR-0722RL; Digi-Key P/N 311-22GRCT-ND
R45: 12K1, 1%; R_0603; Manufacturer P/N RC0603FR-0712K1L; Digi-Key P/N 311-12.1KHRCT-ND
R46: 1M; R_0603; Manufacturer P/N RC0603JR-071ML; Digi-Key P/N 311-1.0MGRCT-ND
R47, R48: 270R; R_0603; Manufacturer P/N RC0603JR-07270RL; Digi-Key P/N 311-270GRCT-ND
R49, R50: 3K3; R_0603; Manufacturer P/N RC0603JR-073K3L; Digi-Key P/N 311-3.3KGRCT-ND
U2: LAN8720A; LAN8720A-CP; Manufacturer P/N LAN8720A-CP; Digi-Key P/N 638-1080-ND
U3: 74LVC1G04GW; SOT-353_SC-70-5; Manufacturer P/N 74LVC1G04GW,125; Digi-Key P/N 1727-2871-1-ND
U4: 24LC64; 24LC64T-I&slash_SN; Manufacturer P/N 24LC64T-I/SN; Digi-Key P/N 24LC64T-I/SNCT-ND
Y3: 25MHz; Crystal_SMD_3225-4pin_3.2x2.5mm; Manufacturer P/N ECS-250-8-33-JGN-TR; Digi-Key P/N XC2650CT-ND

Connections:
+3V3: C20.1, C21.1, C32.1, C33.1, L2.1, R31.1, R32.1, R49.1, R50.1, U2.9 (VDDIO), U3.3 (GND), U4.8 (VCC); also elsewhere on the board
/ETH_RXN: C29.1, R28.2, U2.22 (RXN); also elsewhere on the board
/ETH_RXP: C28.1, R27.2, U2.23 (RXP); also elsewhere on the board
/ETH_TXN: C27.1, R30.2, U2.20 (TXN); also elsewhere on the board
/ETH_TXP: C26.1, R29.2, U2.21 (TXP); also elsewhere on the board
/LAN8720/P1.0-RMII_TXD0: R34.2; also elsewhere on the board
/LAN8720/P1.1-RMII_TXD1: R35.2; also elsewhere on the board
/LAN8720/P1.4-RMII_TXEN: R36.2; also elsewhere on the board
/LAN8720/P1.8-RMII_CRS: R40.2; also elsewhere on the board
/LAN8720/P1.9-RMII_RXD0: R37.2; also elsewhere on the board
/LAN8720/P1.10-RMII_RXD1: R38.2; also elsewhere on the board
/LAN8720/P1.14-RMII_RXER: R39.2; also elsewhere on the board
/LAN8720/P1.15-RMII_CLK: R41.2, U2.15 (RST); also elsewhere on the board
/LAN8720/P1.16-RMII_MCD: U2.13 (MDC); also elsewhere on the board
/LAN8720/P1.17-RMII_MDIO: R31.2, U2.12 (MDIO); also elsewhere on the board
/LAN8720/VDD3_3A: C17.1, C18.1, C19.1, C24.1, C25.1, L2.2, R27.1, R28.1, R29.1, R30.1, U2.1 (VDD2A), U2.19 (VDD1A)
/P0.19: R50.2, U4.5 (SDA); also elsewhere on the board
/P0.20: R49.2, U4.6 (SCL); also elsewhere on the board
GND: C17.2, C18.2, C19.2, C20.2, C21.2, C22.2, C23.2, C24.2, C25.2, C26.2, C27.2, C28.2, C29.2, C30.2, C31.2, C32.2, C33.2, LED3.1 (K), LED4.1 (K), R33.2, R43.1, R45.1, U2.25 (VSS), U3.5 (VCC), U4.1 (A0), U4.2 (A1), U4.3 (A2), U4.4 (GND), U4.7 (WP), Y3.2, Y3.4; also elsewhere on the board
unnamed: C22.1, C23.1, U2.6 (VDDCR)
unnamed: C30.1, R46.2, U2.5 (XTAL1/CLKIN), Y3.1
unnamed: C31.1, R46.1, U2.4 (XTAL2), Y3.3
unnamed: LED3.2 (A), R48.1
unnamed: LED4.2 (A), R47.1
unnamed: R32.2, R39.1, U2.10 (RXER/PHYAD0)
unnamed: R33.1, R37.1, U2.8 (RXD0/MODE0)
unnamed: R34.1, U2.17 (TXD0)
unnamed: R35.1, U2.18 (TXD1)
unnamed: R36.1, U2.16 (TXEN)
unnamed: R38.1, U2.7 (RXD1/MODE1)
unnamed: R40.1, U2.11 (CRS_DV/MODE2)
unnamed: R41.1, R44.2, U3.4
unnamed: R42.1, U2.14 (INT/REFCLKO)
unnamed: R42.2, R44.1, U3.2
unnamed: R43.2, R48.2, U2.2 (LED2/nINTSEL)
unnamed: R45.2, U2.24 (RBIAS)
unnamed: R47.2, U2.3 (LED1/REGOFF)

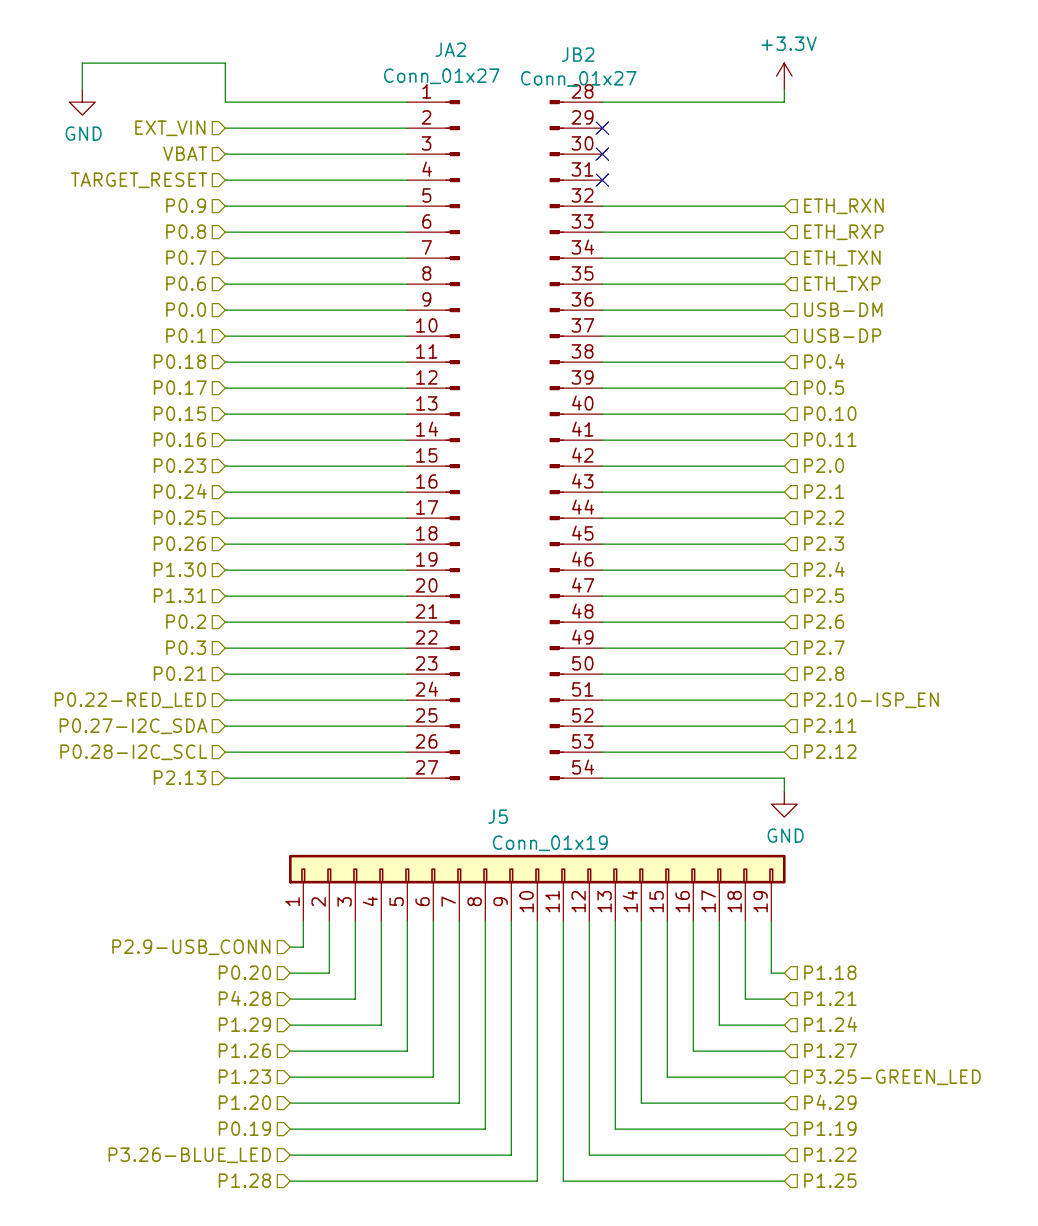
[picture p25: schematic expansion_conn.kicad_sch, Módulo Stick LPC1769]

Parts:
J5: Conn_01x19; conn_x19_Pitch2.54mm; Manufacturer P/N 0022284190; Digi-Key P/N WM50014-19-ND
JA2: Conn_01x27; J2_A_1x27_Pitch2.54mm; Manufacturer P/N 0022284270; Digi-Key P/N WM50014-27-ND
JB2: Conn_01x27; J2_B_01x27_Pitch2.54mm; Manufacturer P/N 0022284270; Digi-Key P/N WM50014-27-ND

Connections:
+3V3: JB2.28; also elsewhere on the board
/ETH_RXN: JB2.32; also elsewhere on the board
/ETH_RXP: JB2.33; also elsewhere on the board
/ETH_TXN: JB2.34; also elsewhere on the board
/ETH_TXP: JB2.35; also elsewhere on the board
/EXT_VIN: JA2.2; also elsewhere on the board
/Expansion_connector/P0.15: JA2.13; also elsewhere on the board
/Expansion_connector/P0.16: JA2.14; also elsewhere on the board
/Expansion_connector/P0.17: JA2.12; also elsewhere on the board
/Expansion_connector/P0.18: JA2.11; also elsewhere on the board
/Expansion_connector/P0.21: JA2.23; also elsewhere on the board
/Expansion_connector/P0.22-RED_LED: JA2.24; also elsewhere on the board
/Expansion_connector/P0.23: JA2.15; also elsewhere on the board
/Expansion_connector/P0.24: JA2.16; also elsewhere on the board
/Expansion_connector/P0.25: JA2.17; also elsewhere on the board
/Expansion_connector/P0.26: JA2.18; also elsewhere on the board
/Expansion_connector/P0.27-I2C_SDA: JA2.25; also elsewhere on the board
/Expansion_connector/P0.28-I2C_SCL: JA2.26; also elsewhere on the board
/Expansion_connector/P1.18: J5.19; also elsewhere on the board
/Expansion_connector/P1.19: J5.13; also elsewhere on the board
/Expansion_connector/P1.20: J5.7; also elsewhere on the board
/Expansion_connector/P1.21: J5.18; also elsewhere on the board
/Expansion_connector/P1.22: J5.12; also elsewhere on the board
/Expansion_connector/P1.23: J5.6; also elsewhere on the board
/Expansion_connector/P1.24: J5.17; also elsewhere on the board
/Expansion_connector/P1.25: J5.11; also elsewhere on the board
/Expansion_connector/P1.26: J5.5; also elsewhere on the board
/Expansion_connector/P1.27: J5.16; also elsewhere on the board
/Expansion_connector/P1.28: J5.10; also elsewhere on the board
/Expansion_connector/P1.29: J5.4; also elsewhere on the board
/Expansion_connector/P1.30: JA2.19; also elsewhere on the board
/Expansion_connector/P1.31: JA2.20; also elsewhere on the board
/Expansion_connector/P2.0: JB2.42 (Pin_12); also elsewhere on the board
/Expansion_connector/P2.1: JB2.43 (Pin_13); also elsewhere on the board
/Expansion_connector/P2.2: JB2.44 (Pin_14); also elsewhere on the board
/Expansion_connector/P2.3: JB2.45 (Pin_15); also elsewhere on the board
/Expansion_connector/P2.4: JB2.46 (Pin_16); also elsewhere on the board
/Expansion_connector/P2.5: JB2.47 (Pin_17); also elsewhere on the board
/Expansion_connector/P2.6: JB2.48 (Pin_18); also elsewhere on the board
/Expansion_connector/P2.7: JB2.49 (Pin_19); also elsewhere on the board
/Expansion_connector/P2.8: JB2.50 (Pin_20); also elsewhere on the board
/Expansion_connector/P2.11: JB2.52 (Pin_22); also elsewhere on the board
/Expansion_connector/P2.12: JB2.53 (Pin_23); also elsewhere on the board
/Expansion_connector/P2.13: JA2.27; also elsewhere on the board
/Expansion_connector/P3.25-GREEN_LED: J5.15; also elsewhere on the board
/Expansion_connector/P3.26-BLUE_LED: J5.9; also elsewhere on the board
/Expansion_connector/P4.28: J5.3; also elsewhere on the board
/Expansion_connector/P4.29: J5.14; also elsewhere on the board
/P0.0: JA2.9; also elsewhere on the board
/P0.1: JA2.10; also elsewhere on the board
/P0.2: JA2.21; also elsewhere on the board
/P0.3: JA2.22; also elsewhere on the board
/P0.4: JB2.38; also elsewhere on the board
/P0.5: JB2.39; also elsewhere on the board
/P0.6: JA2.8; also elsewhere on the board
/P0.7: JA2.7; also elsewhere on the board
/P0.8: JA2.6; also elsewhere on the board
/P0.9: JA2.5; also elsewhere on the board
/P0.10: JB2.40; also elsewhere on the board
/P0.11: JB2.41 (Pin_11); also elsewhere on the board
/P0.19: J5.8; also elsewhere on the board
/P0.20: J5.2; also elsewhere on the board
/P2.9-USB_CONN: J5.1; also elsewhere on the board
/P2.10-ISP_EN: JB2.51 (Pin_21); also elsewhere on the board
/TARGET_RESET: JA2.4; also elsewhere on the board
/USB-DM: JB2.36; also elsewhere on the board
/USB-DP: JB2.37; also elsewhere on the board
GND: JA2.1, JB2.54 (Pin_24); also elsewhere on the board

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
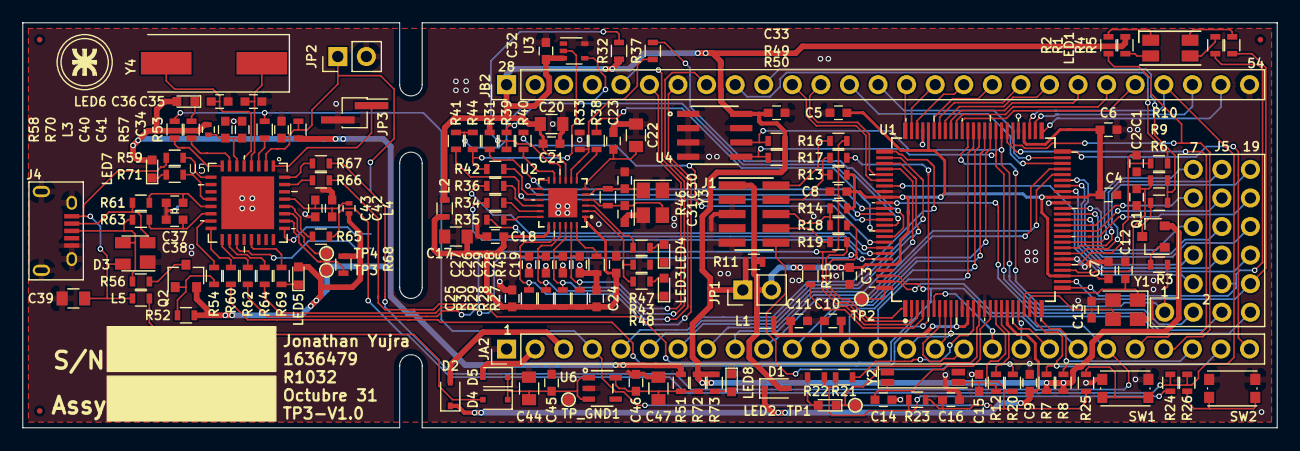
[picture p26: board Módulo Stick LPC 1769.kicad_pcb from above]

Board: 2 copper layers, 111.5 x 36.0 mm, 166 parts (1 on the bottom side), 169 nets.

Other parts of the board:
LogoUTN.BA: UTN.BA
